Andrey-Nedov/DRUID-humanoid-robot/imgs/c1/1.jpg

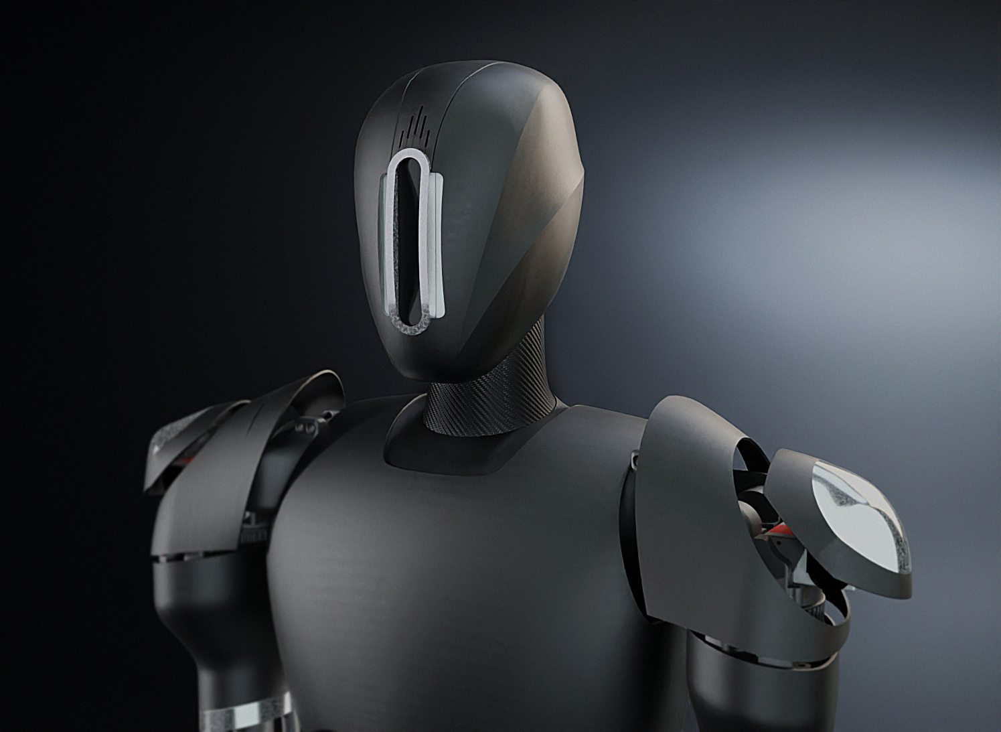
imgs/c1/1.jpg
