Andrey-Nedov/DRUID-humanoid-robot/imgs/c1/2.jpg

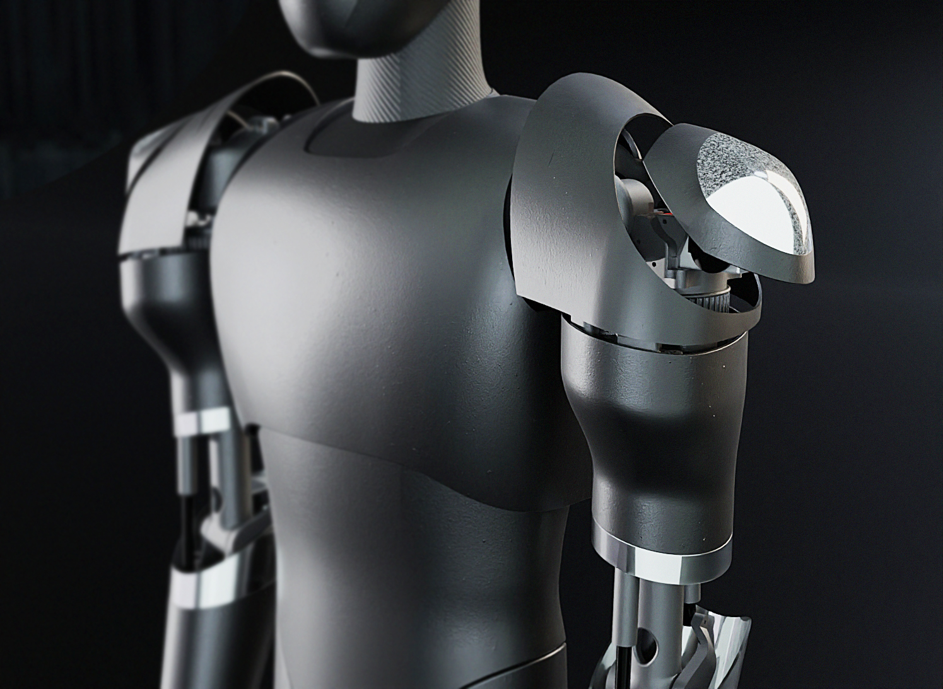
imgs/c1/2.jpg
