Andrey-Nedov/DRUID-humanoid-robot/imgs/c1/3.jpg

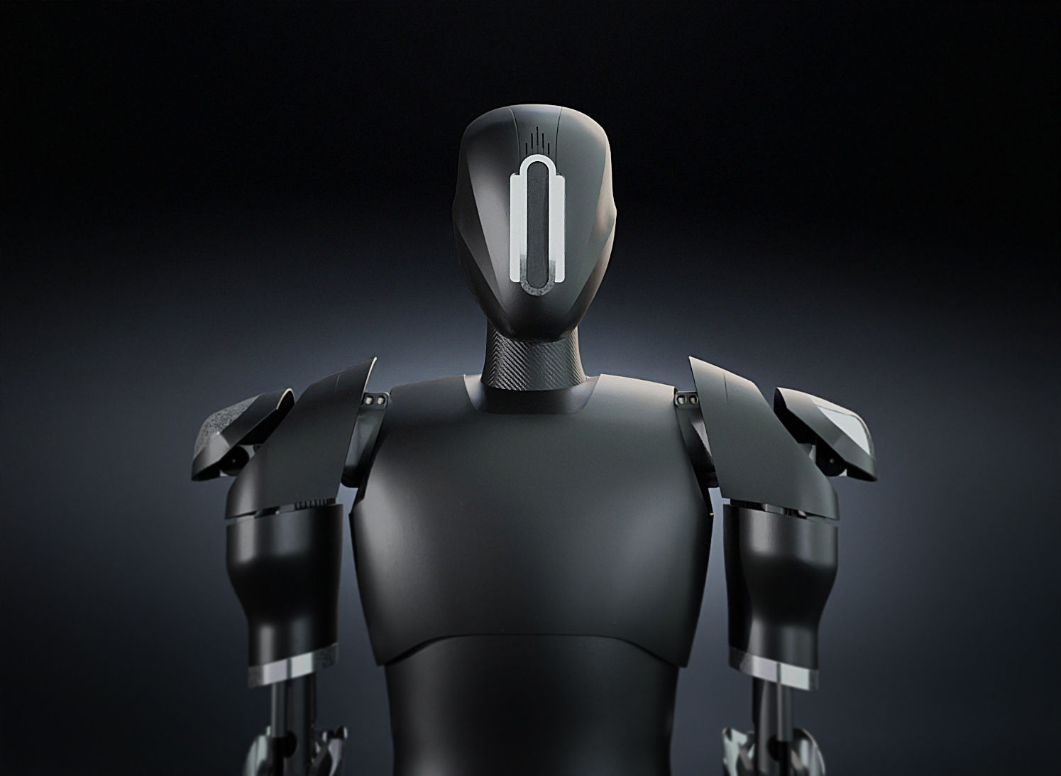
imgs/c1/3.jpg
