Andrey-Nedov/DRUID-humanoid-robot/imgs/c1/4.jpg

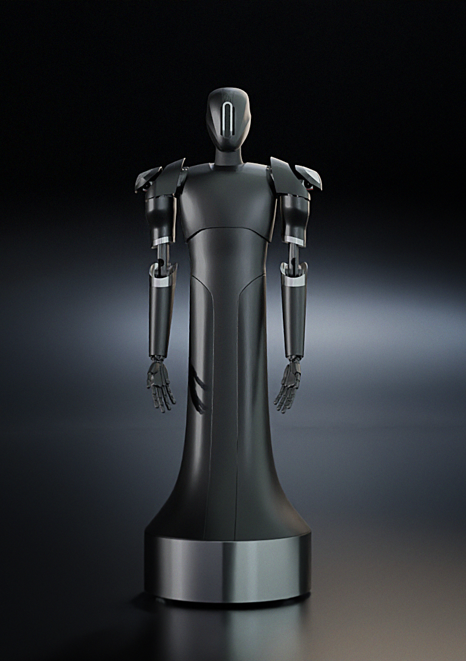
imgs/c1/4.jpg
