Andrey-Nedov/DRUID-humanoid-robot/imgs/c1/5.jpg

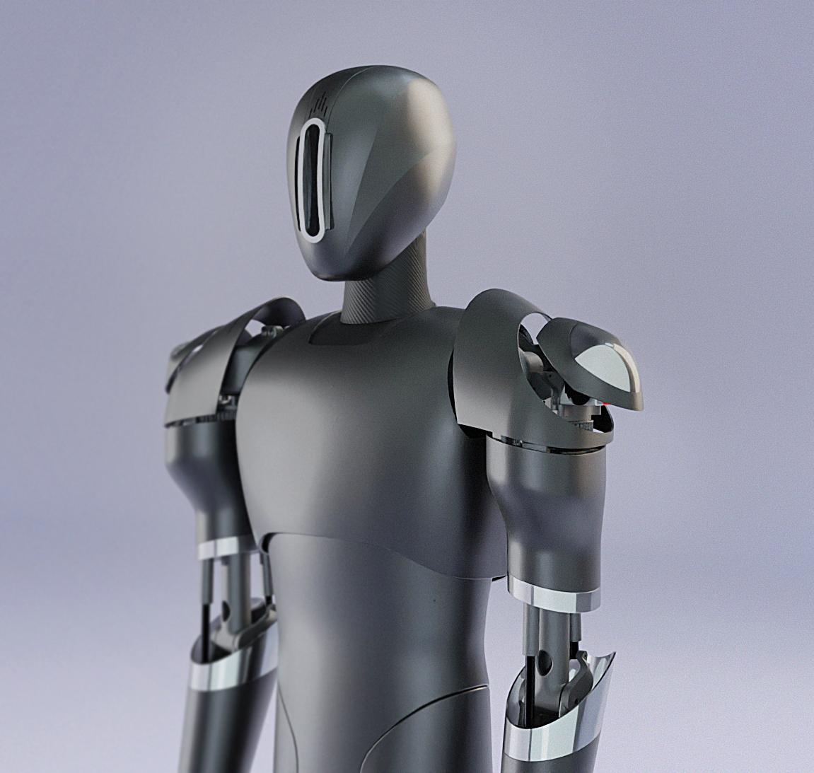
imgs/c1/5.jpg
