Andrey-Nedov/DRUID-humanoid-robot/imgs/c1/6.jpg

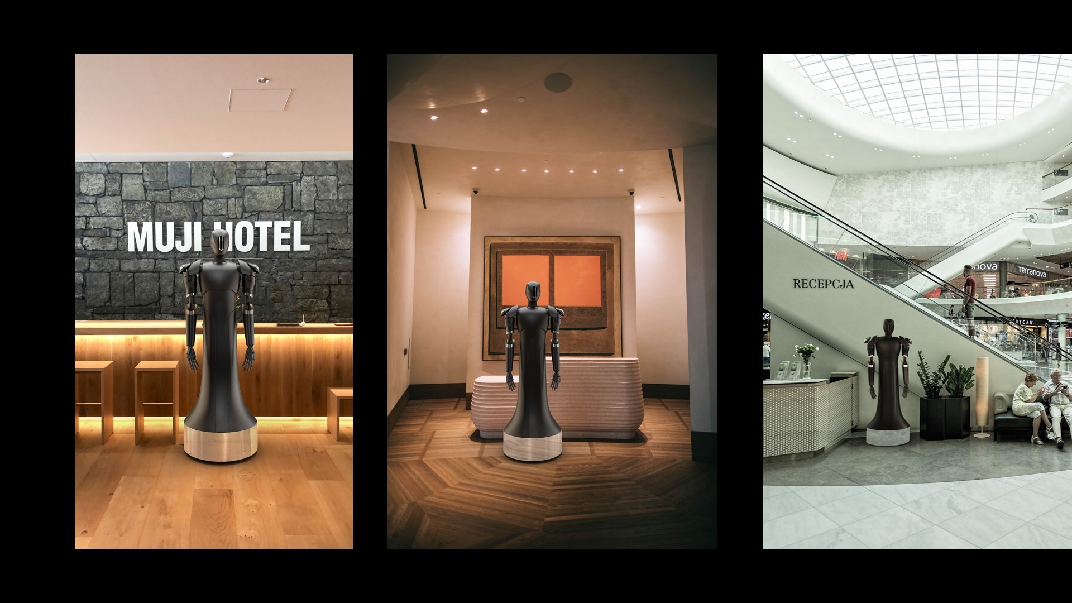
imgs/c1/6.jpg
