Andrey-Nedov/DRUID-humanoid-robot/imgs/c1/c1_1_full-hd.png

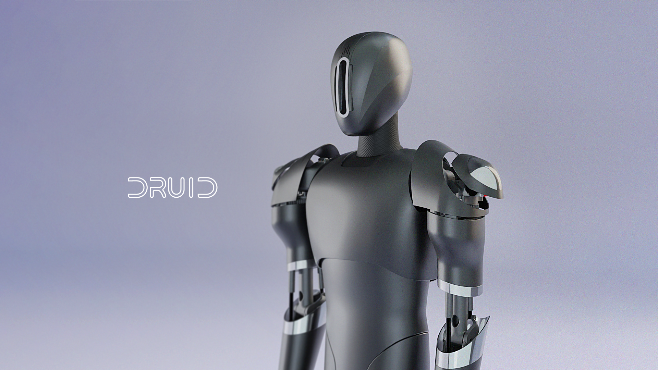
imgs/c1/c1_1_full-hd.png
