Andrey-Nedov/DRUID-humanoid-robot/imgs/c1/c1_2_git.png

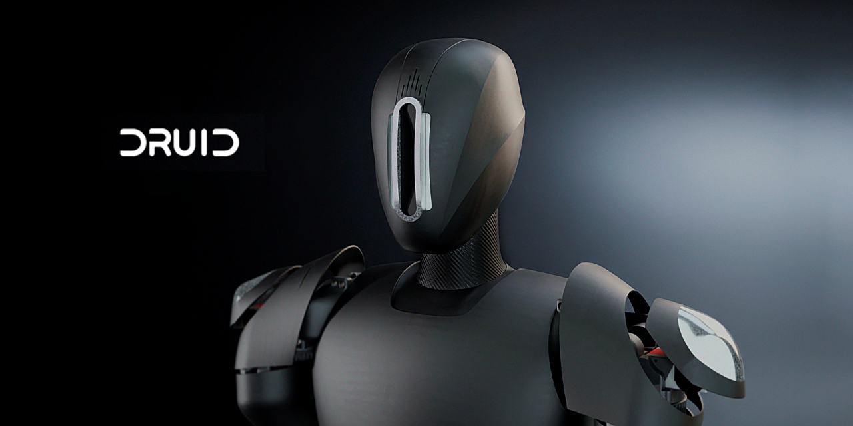
imgs/c1/c1_2_git.png
