Andrey-Nedov/DRUID-humanoid-robot/imgs/c1_2/1.jpg

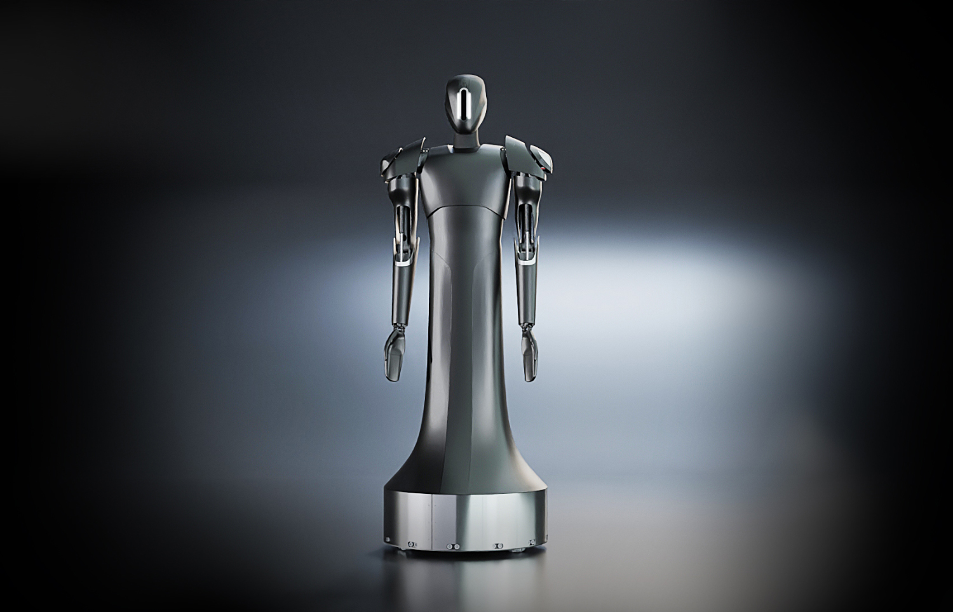
imgs/c1_2/1.jpg
