Andrey-Nedov/DRUID-humanoid-robot/imgs/c1_2/4.jpg

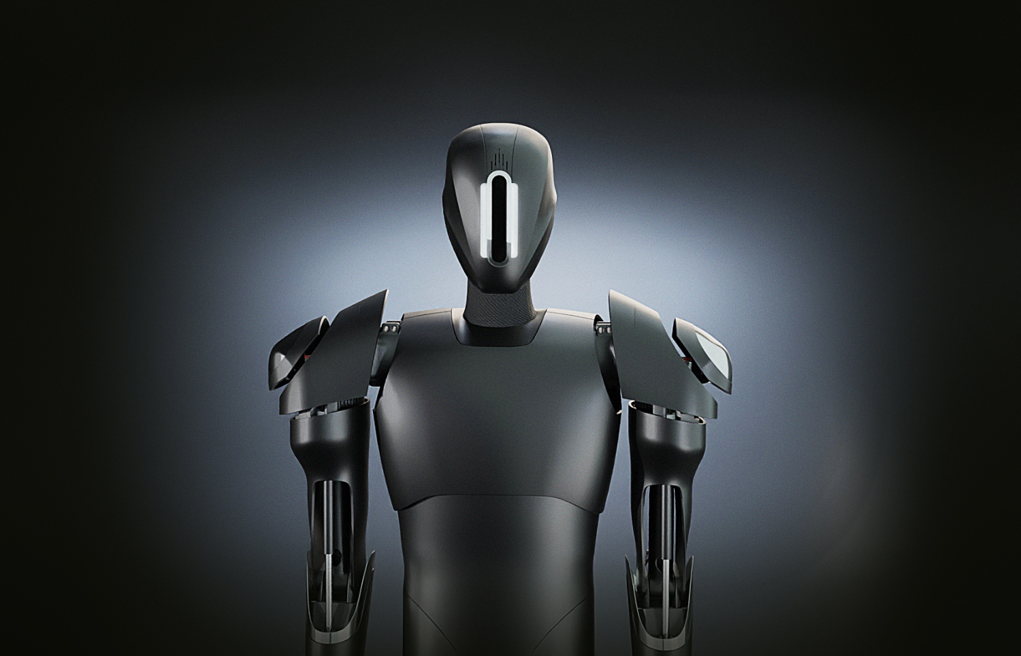
imgs/c1_2/4.jpg
