Andrey-Nedov/DRUID-humanoid-robot/imgs/c1_2/5.jpg

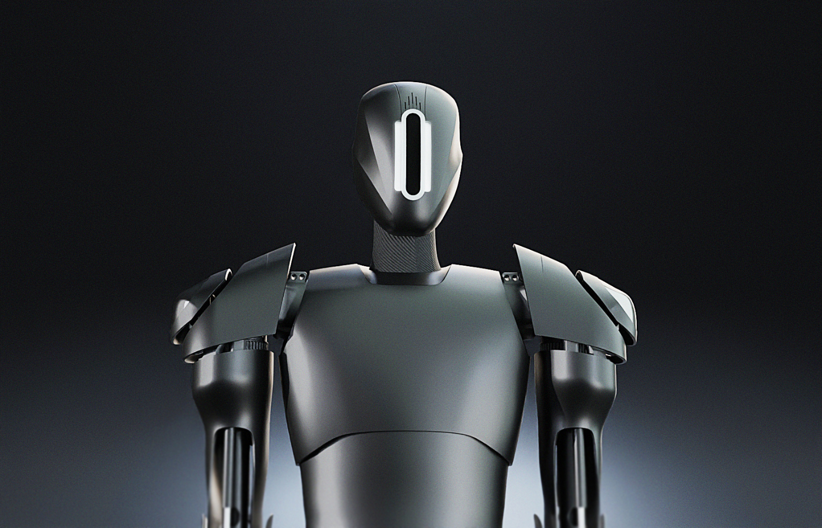
imgs/c1_2/5.jpg
