Andrey-Nedov/DRUID-humanoid-robot/imgs/c1_2/druid.png

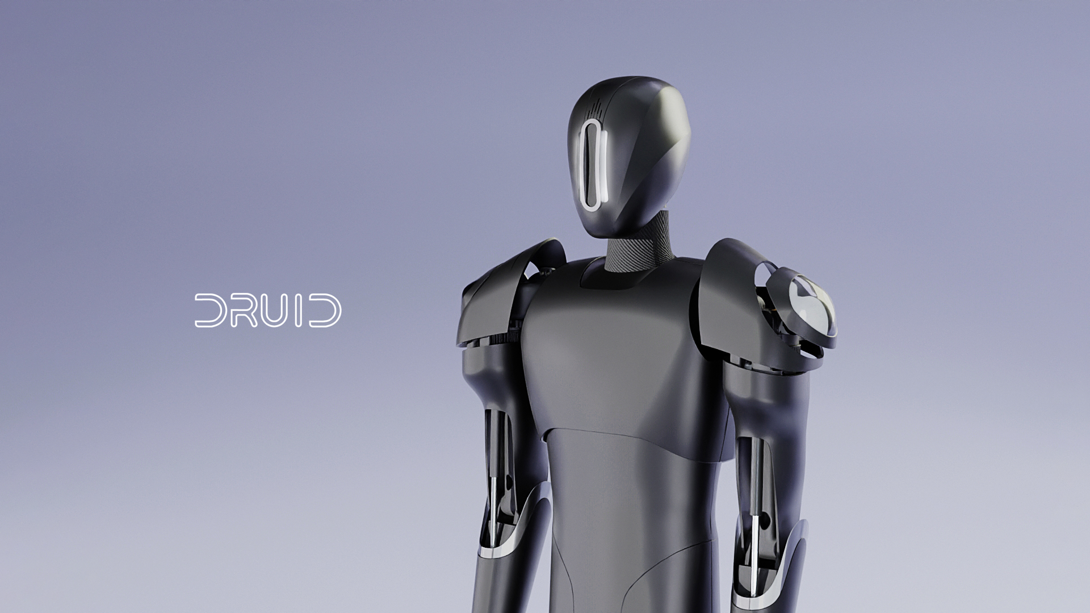
imgs/c1_2/druid.png
