Andrey-Nedov/DRUID-humanoid-robot/imgs/docs/OS.png

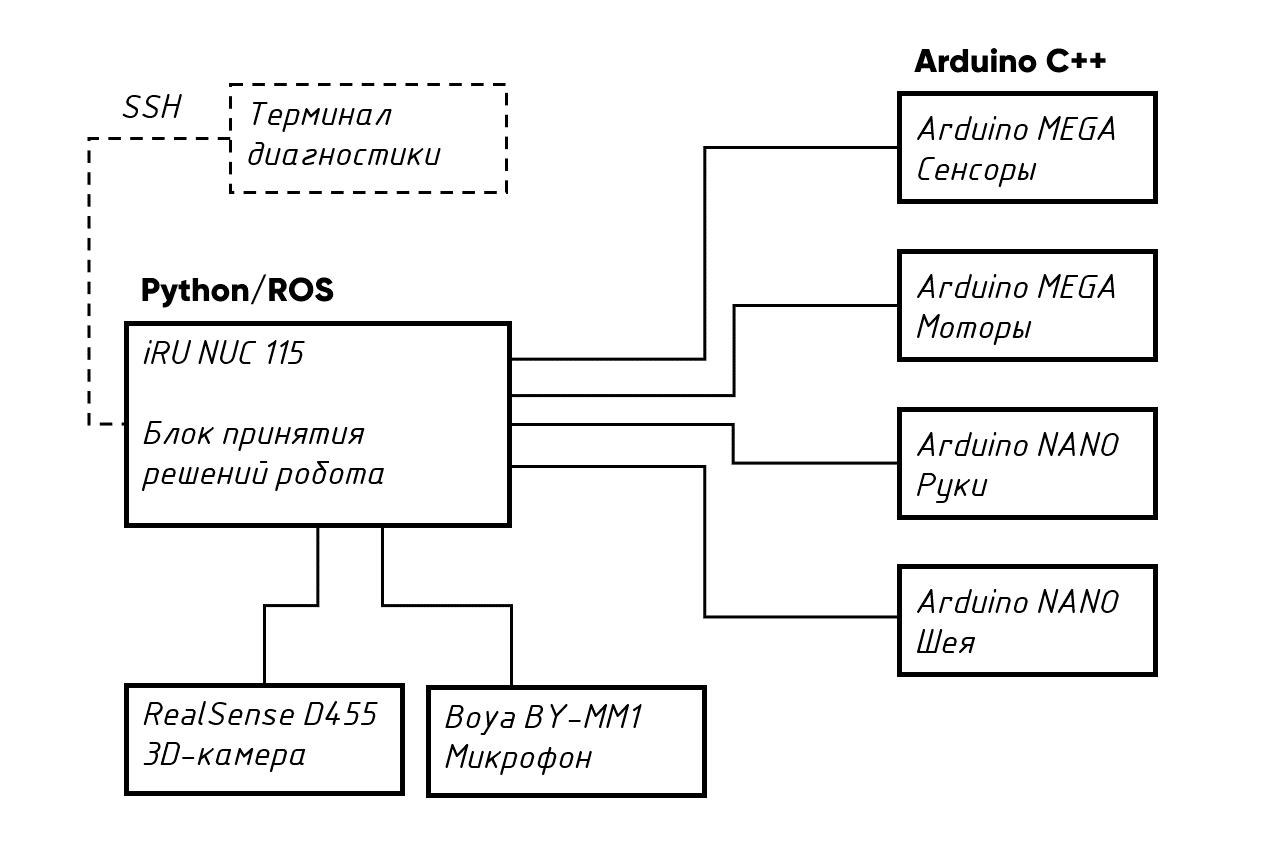
imgs/docs/OS.png
