Andrey-Nedov/DRUID-humanoid-robot/imgs/docs/pl_soft.png

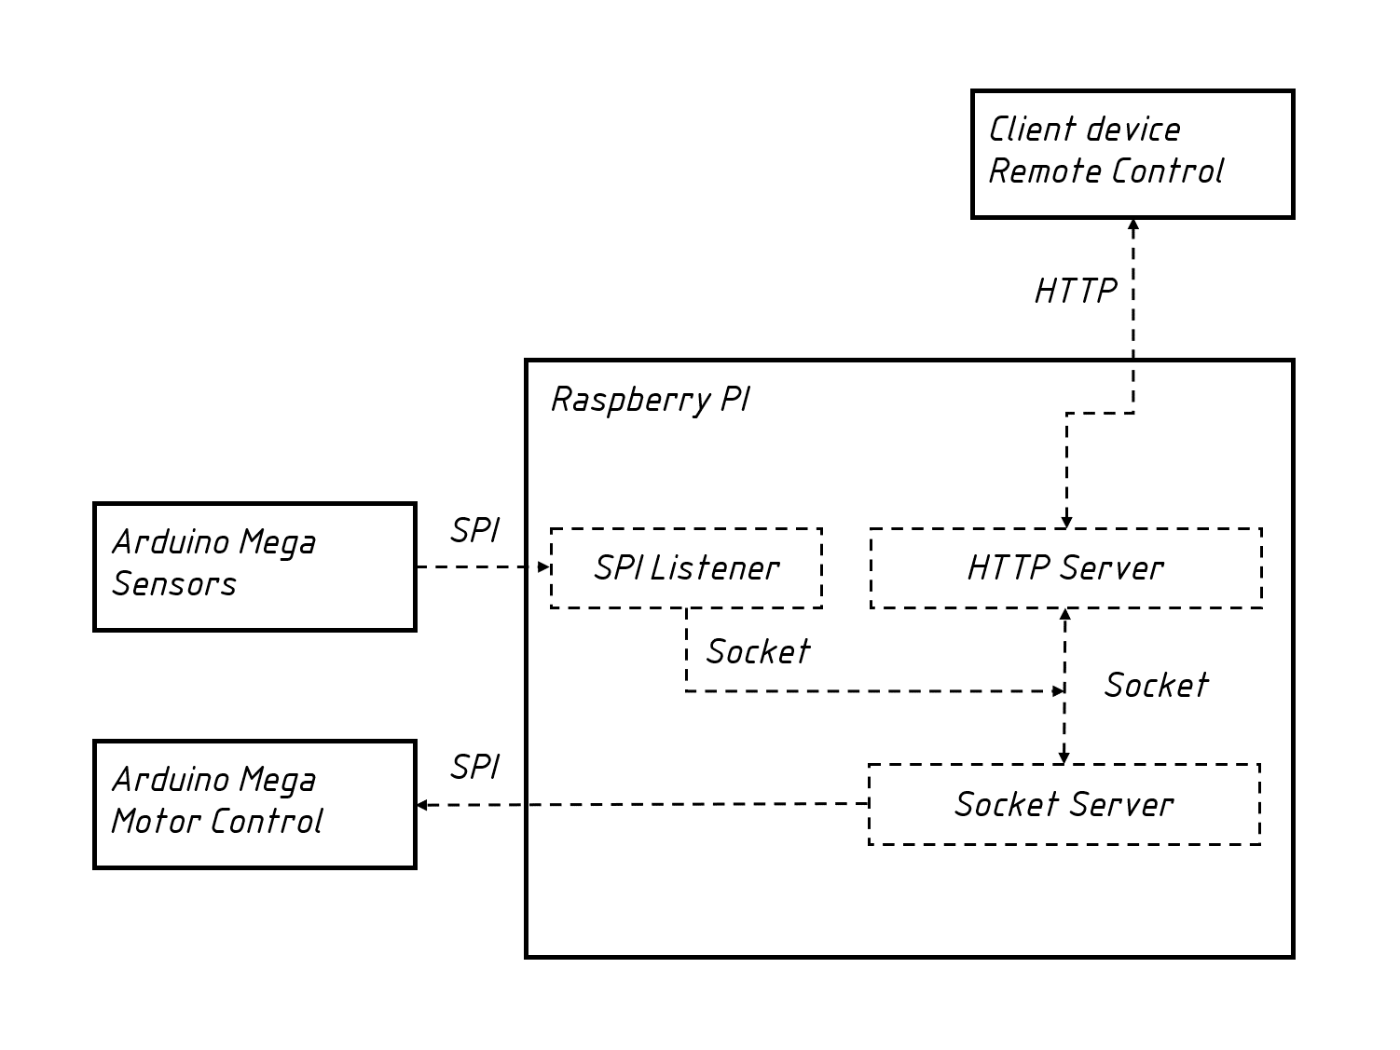
imgs/docs/pl_soft.png
