Andrey-Nedov/DRUID-humanoid-robot/imgs/photos/2.jpg

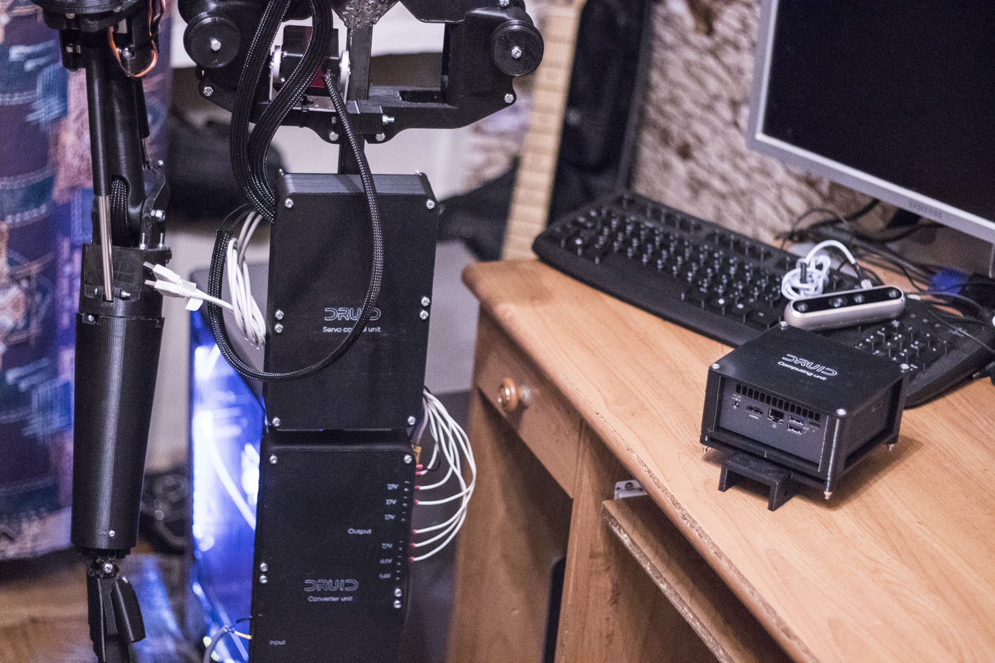
imgs/photos/2.jpg
