Andrey-Nedov/DRUID-humanoid-robot/imgs/photos/2_1.jpg

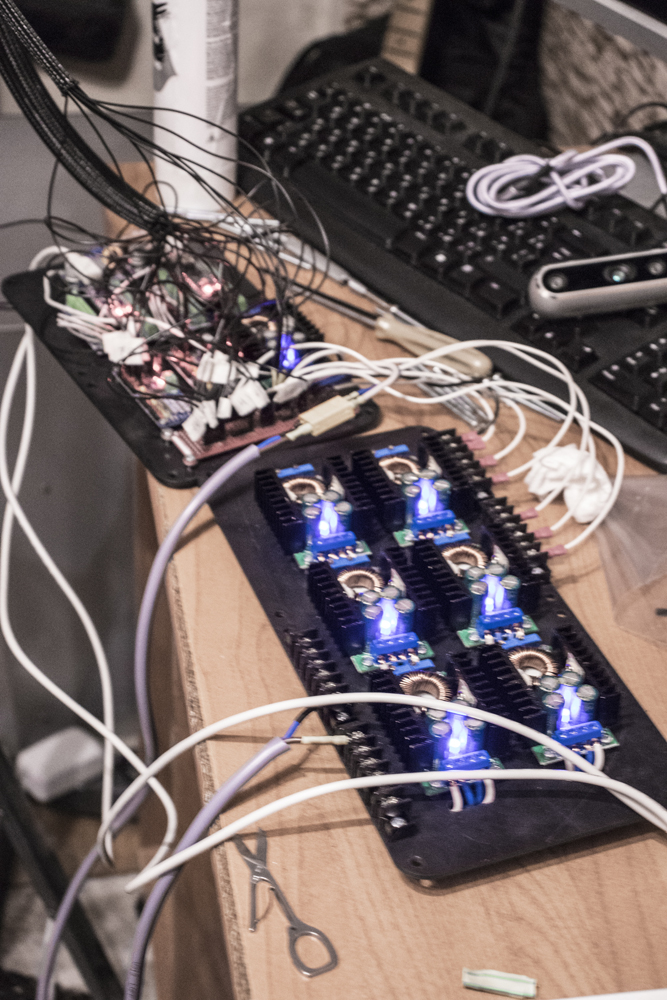
imgs/photos/2_1.jpg
