Andrey-Nedov/DRUID-humanoid-robot/imgs/photos/2_2.jpg

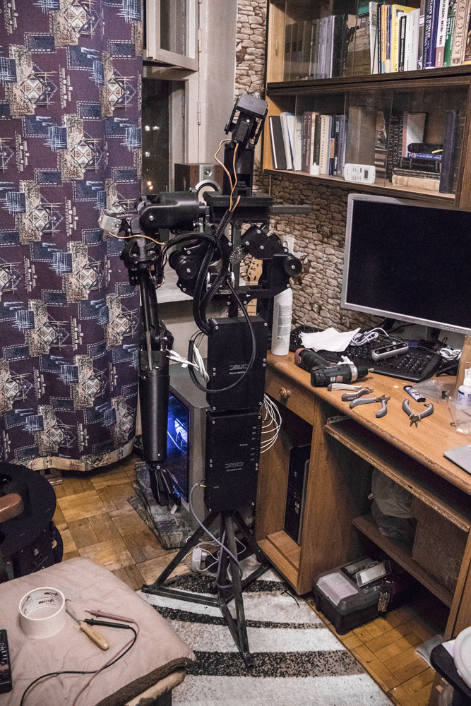
imgs/photos/2_2.jpg
