Andrey-Nedov/DRUID-humanoid-robot/imgs/photos/2_3.jpg

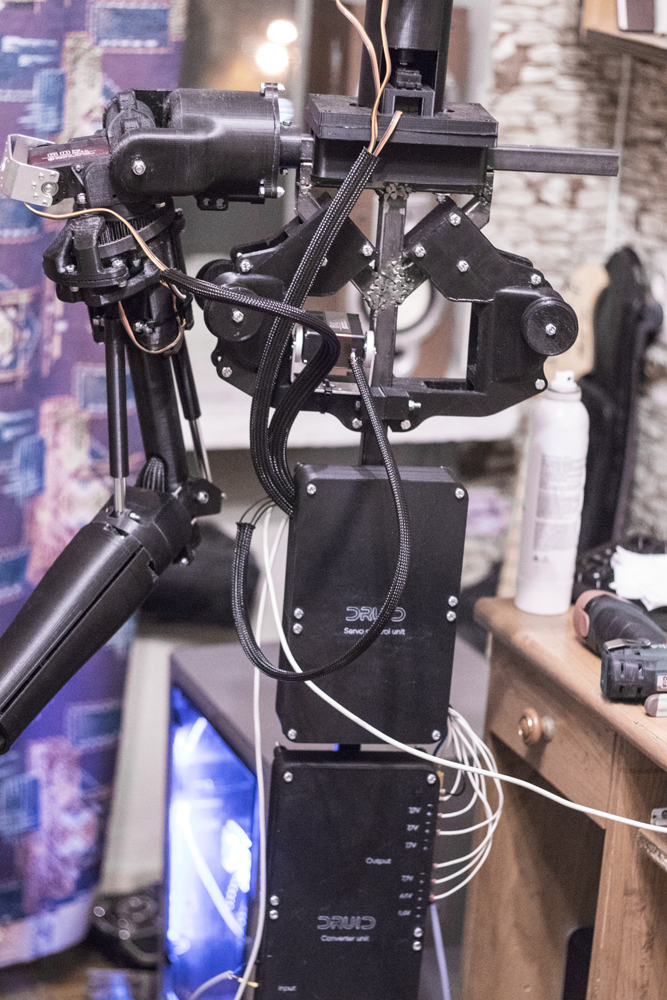
imgs/photos/2_3.jpg
