Andrey-Nedov/DRUID-humanoid-robot/imgs/photos/2_6.jpg

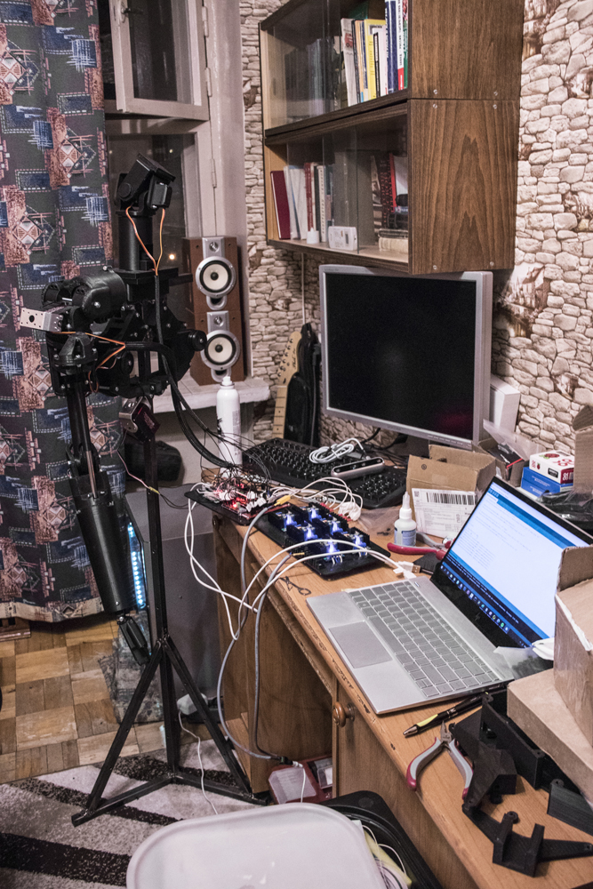
imgs/photos/2_6.jpg
