Andrey-Nedov/DRUID-humanoid-robot/imgs/photos/2_16.jpg

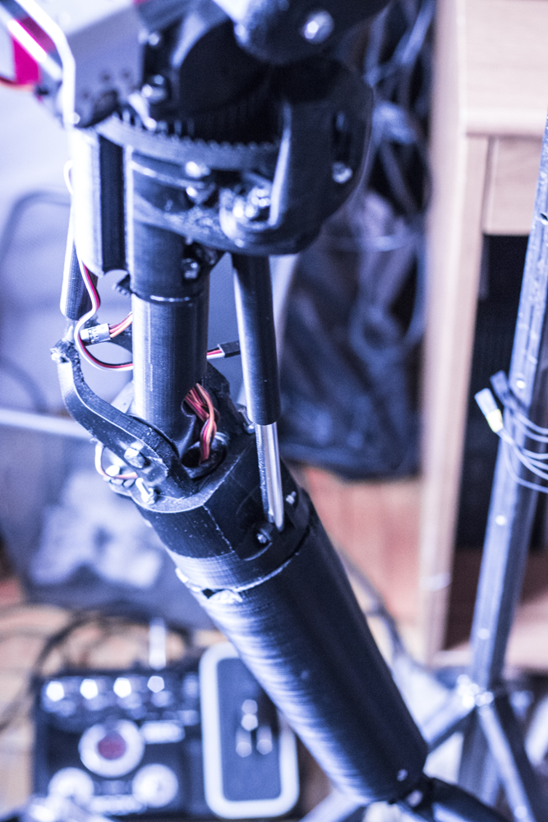
imgs/photos/2_16.jpg
