Andrey-Nedov/DRUID-humanoid-robot/imgs/photos/2_18.jpg

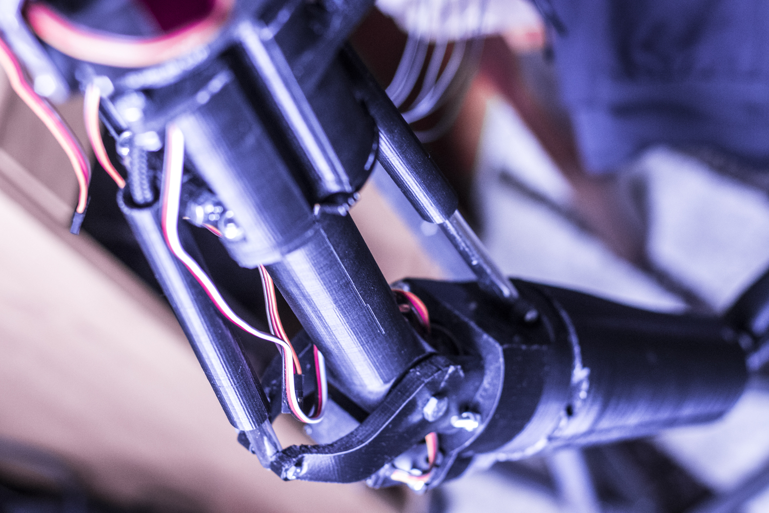
imgs/photos/2_18.jpg
