Andrey-Nedov/DRUID-humanoid-robot/imgs/photos/2_20.jpg

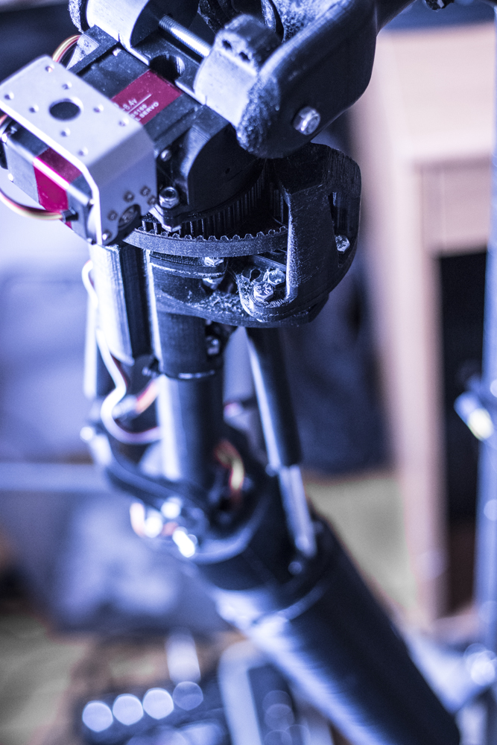
imgs/photos/2_20.jpg
