Andrey-Nedov/DRUID-humanoid-robot/imgs/photos/3.png

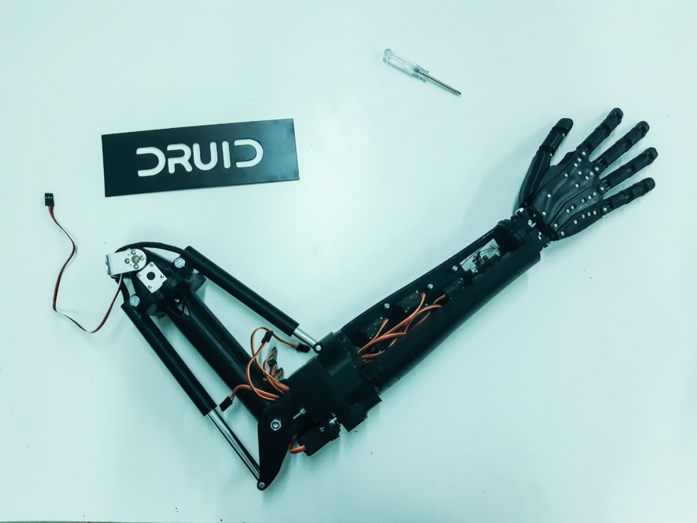
imgs/photos/3.png
