Andrey-Nedov/DRUID-humanoid-robot/imgs/photos/5.jpg

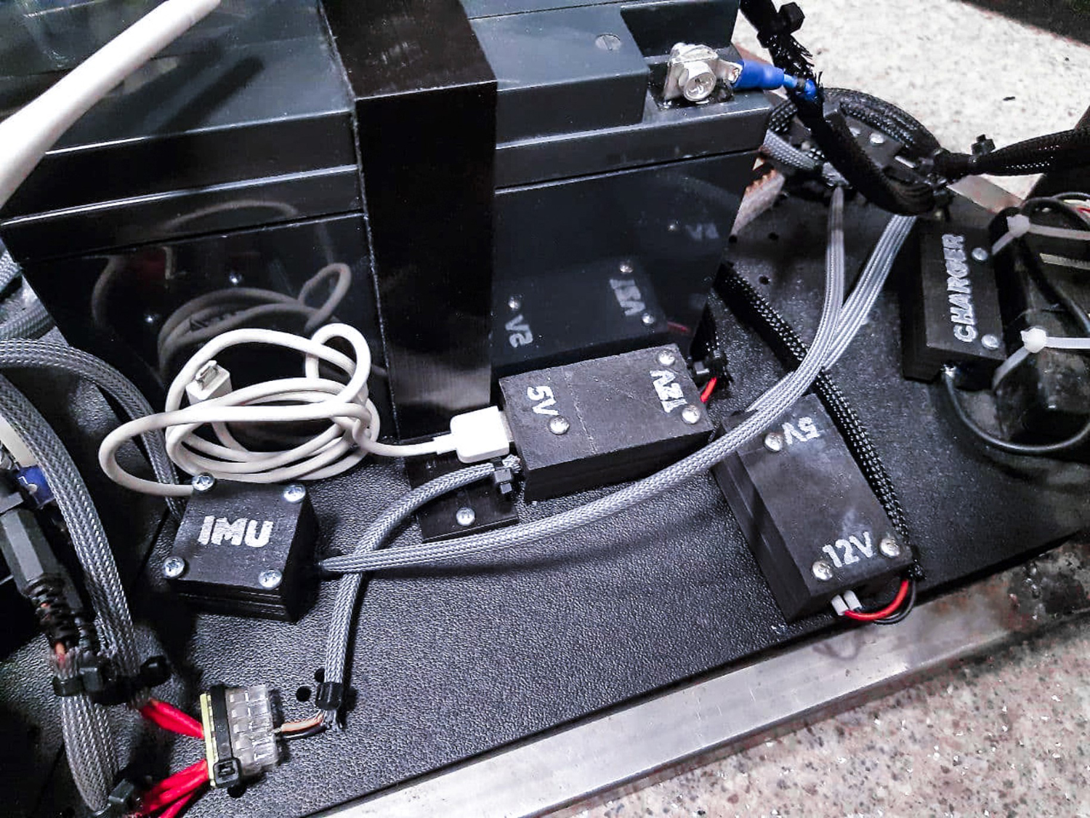
imgs/photos/5.jpg
