Andrey-Nedov/DRUID-humanoid-robot/imgs/photos/6.jpg

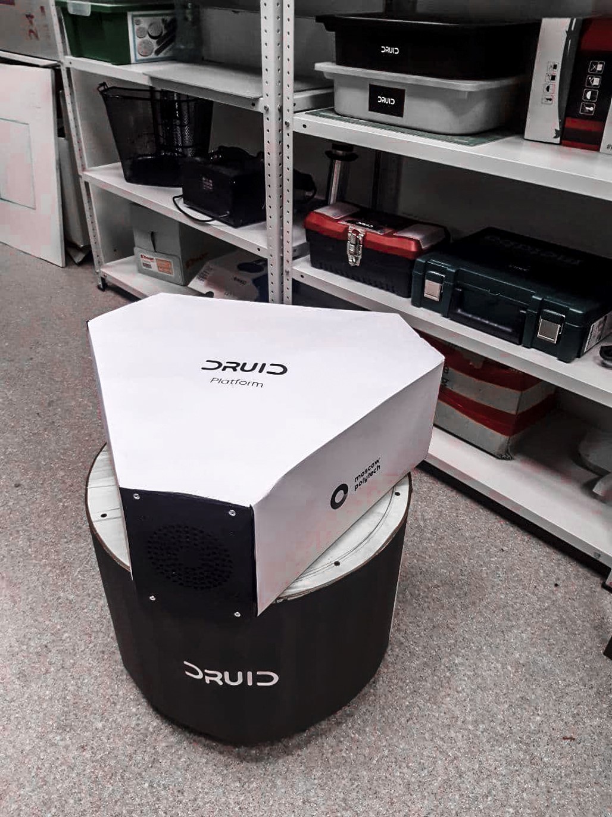
imgs/photos/6.jpg
