Andrey-Nedov/DRUID-humanoid-robot/imgs/photos/10.jpg

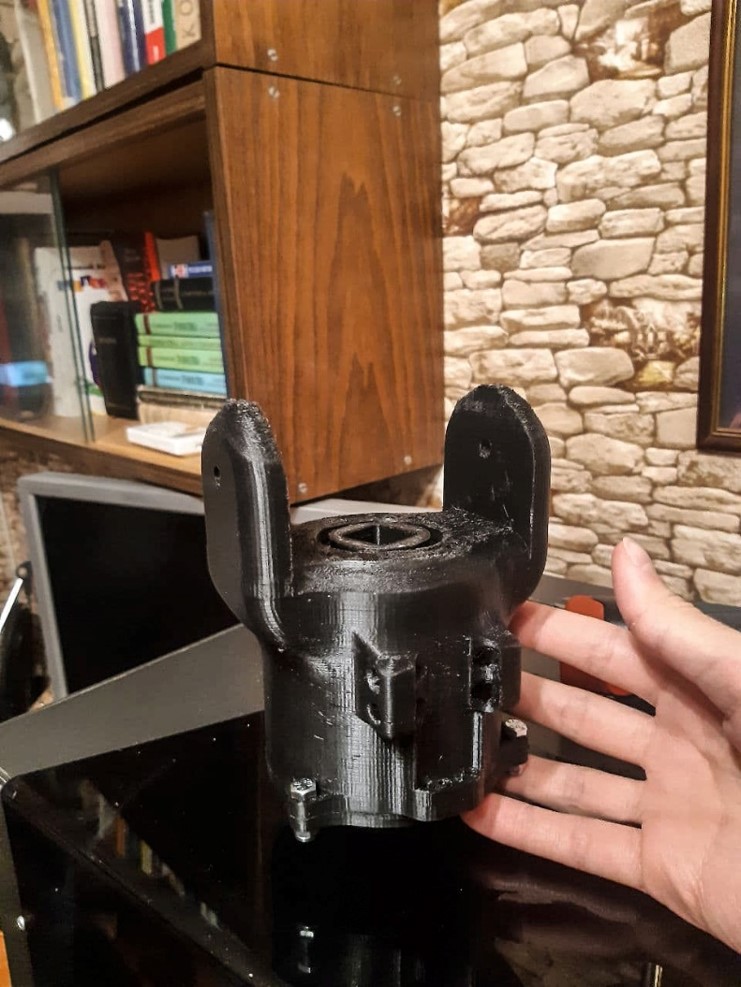
imgs/photos/10.jpg
