Andrey-Nedov/DRUID-humanoid-robot/imgs/photos/face.png

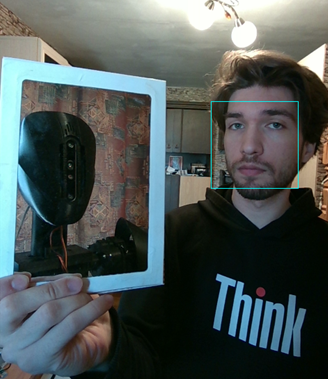
imgs/photos/face.png
