Andrey-Nedov/DRUID-humanoid-robot/imgs/photos/face_2.png

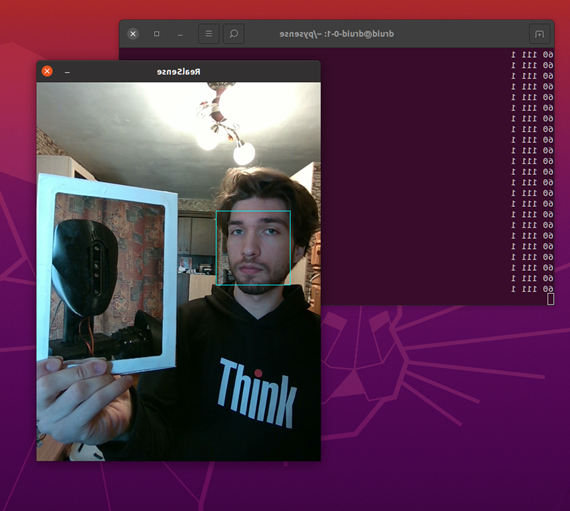
imgs/photos/face_2.png
