Andrey-Nedov/DRUID-humanoid-robot/imgs/photos/next.jpg

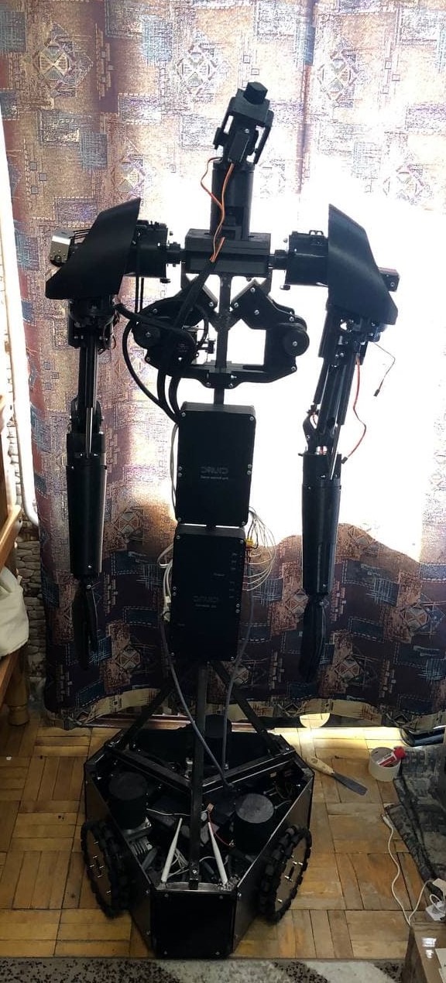
imgs/photos/next.jpg
