Andrey-Nedov/DRUID-humanoid-robot/imgs/renders/1.jpg

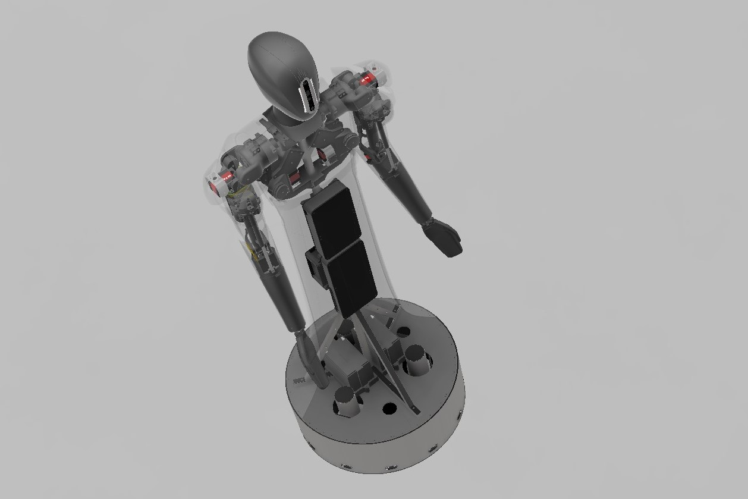
imgs/renders/1.jpg
