Andrey-Nedov/DRUID-humanoid-robot/imgs/renders/2.jpg

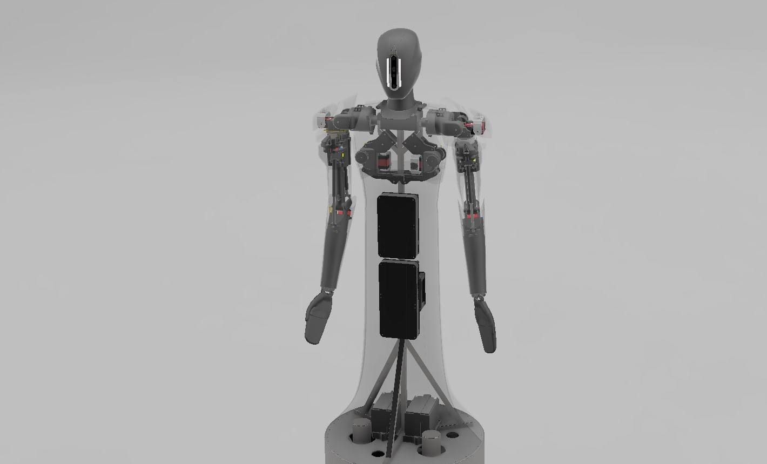
imgs/renders/2.jpg
