Andrey-Nedov/DRUID-humanoid-robot/imgs/renders/bot.gif

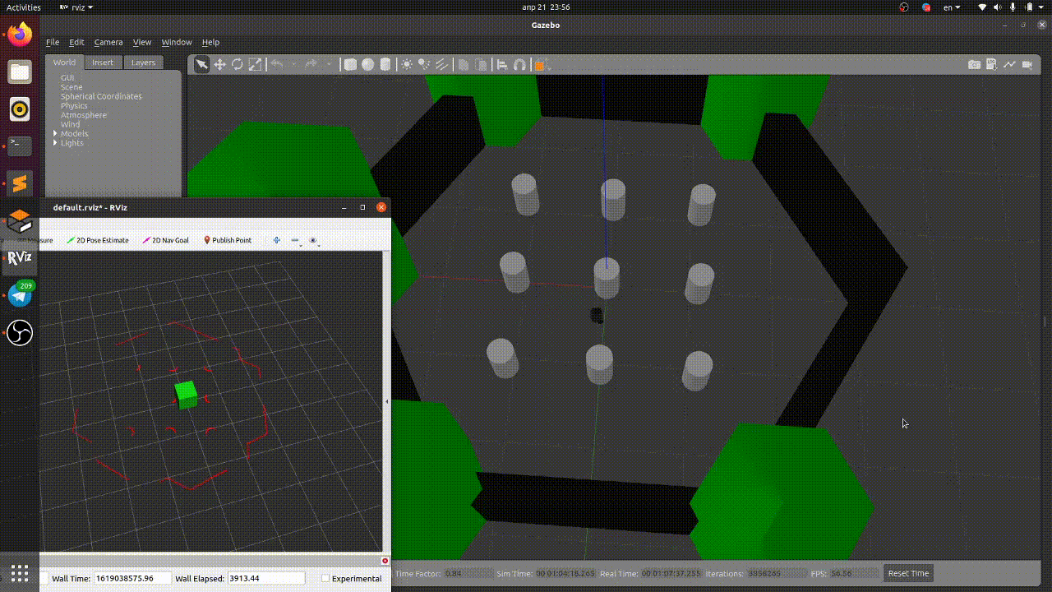
imgs/renders/bot.gif
