Andrey-Nedov/DRUID-humanoid-robot/imgs/renders/bot.png

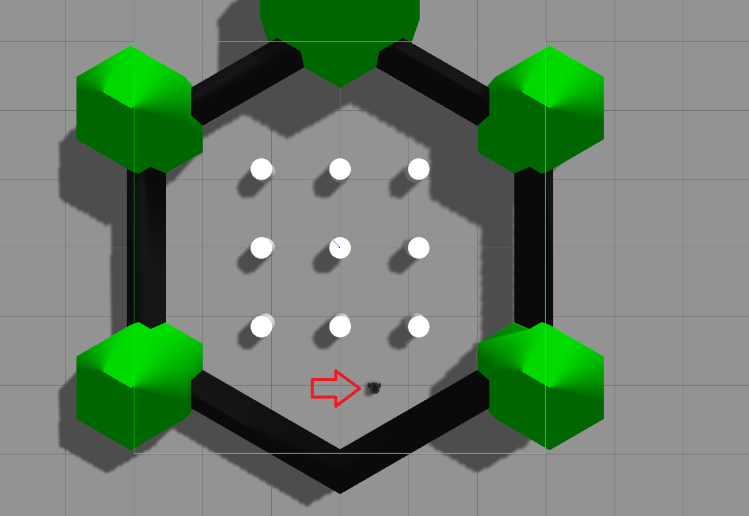
imgs/renders/bot.png
