Andrey-Nedov/DRUID-humanoid-robot/imgs/renders/constr.jpg

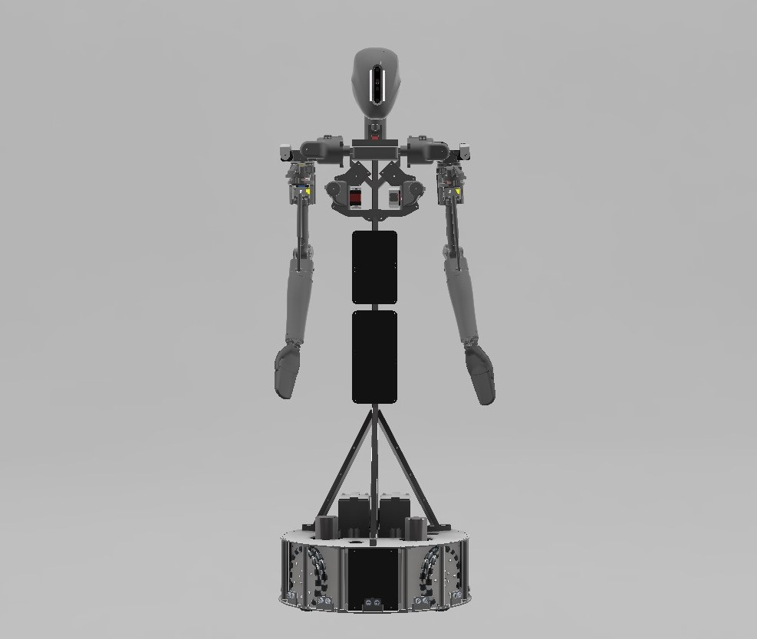
imgs/renders/constr.jpg
