Andrey-Nedov/DRUID-humanoid-robot/imgs/renders/hand.jpg

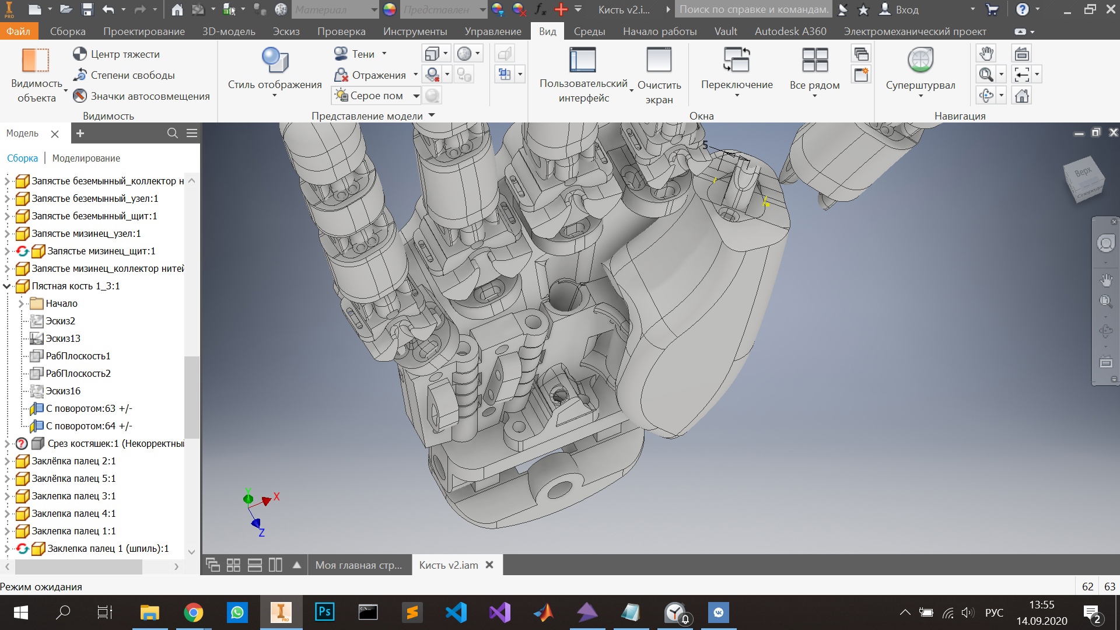
imgs/renders/hand.jpg
