Andrey-Nedov/DRUID-humanoid-robot/imgs/renders/platform/2.png

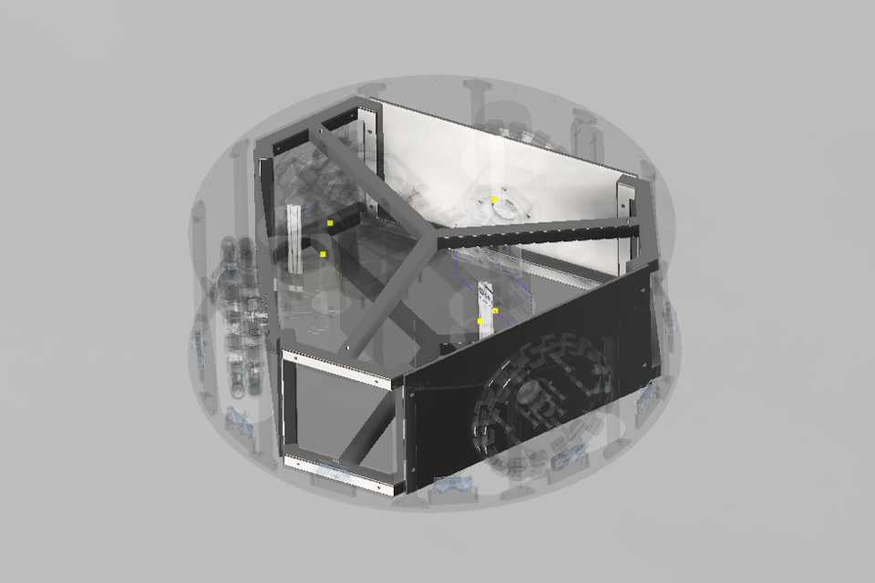
imgs/renders/platform/2.png
