Andrey-Nedov/DRUID-humanoid-robot/imgs/renders/platform/3.png

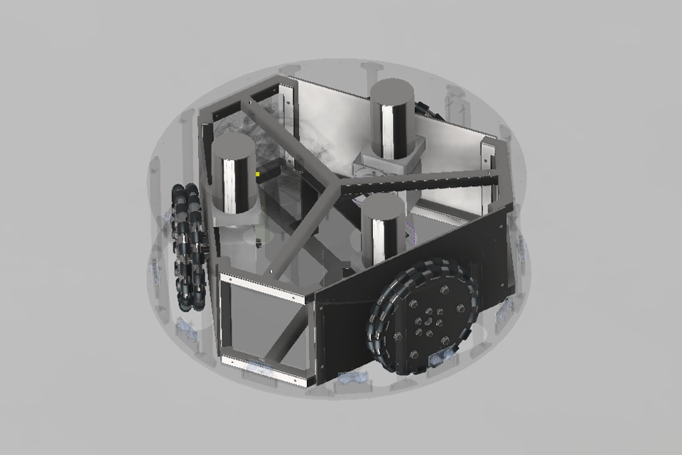
imgs/renders/platform/3.png
