Andrey-Nedov/DRUID-humanoid-robot/imgs/renders/platform/4.png

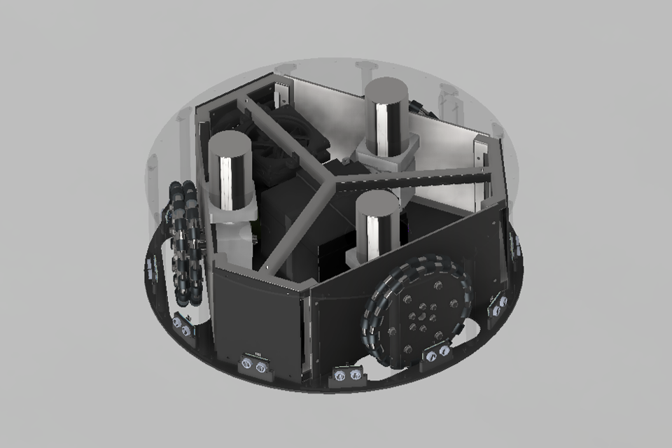
imgs/renders/platform/4.png
