Andrey-Nedov/DRUID-humanoid-robot/imgs/renders/platform/5.png

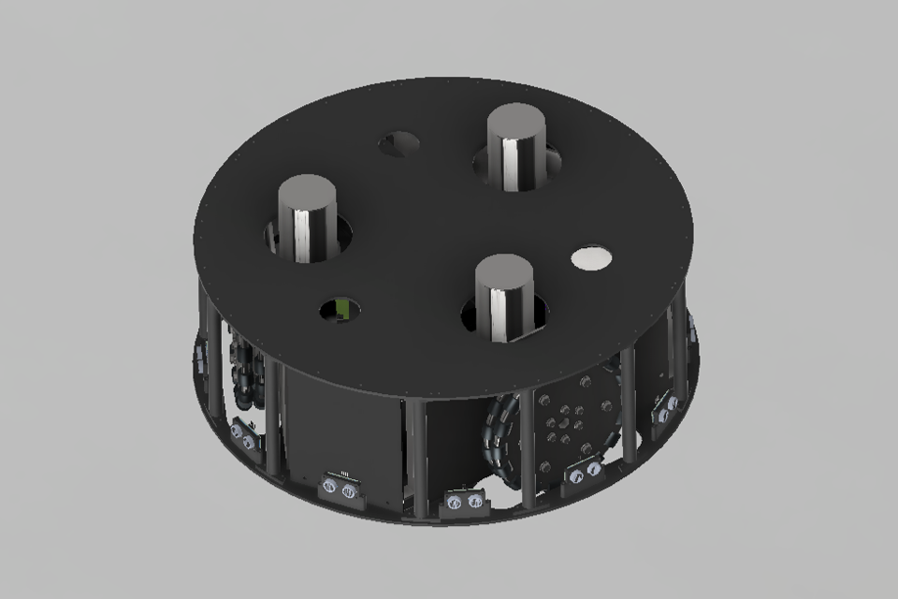
imgs/renders/platform/5.png
