Andrey-Nedov/DRUID-humanoid-robot/imgs/renders/platform/6.png

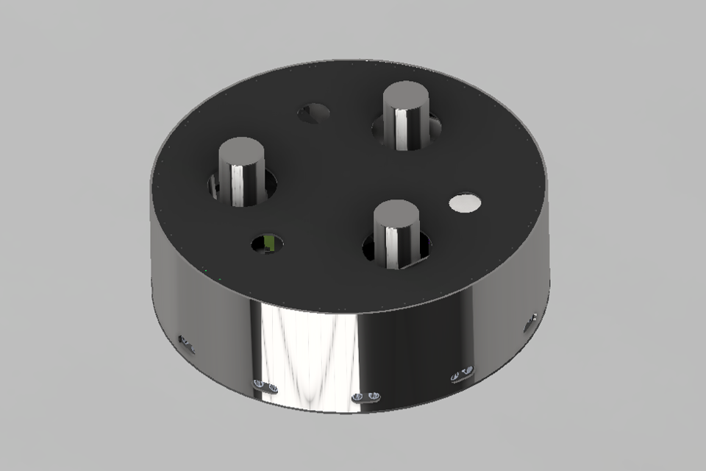
imgs/renders/platform/6.png
