Andrey-Nedov/DRUID-humanoid-robot/imgs/renders/platform/7.jpg

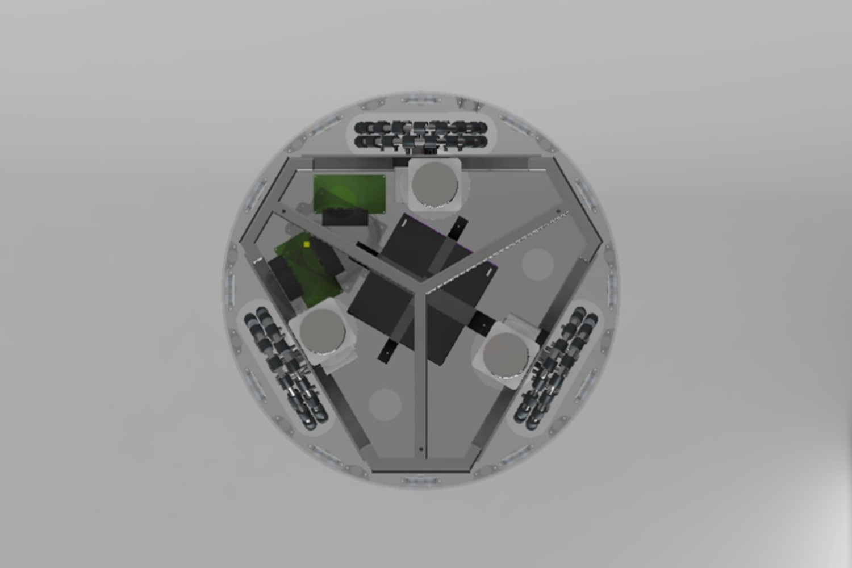
imgs/renders/platform/7.jpg
