Andrey-Nedov/DRUID-humanoid-robot/imgs/renders/platform/10.png

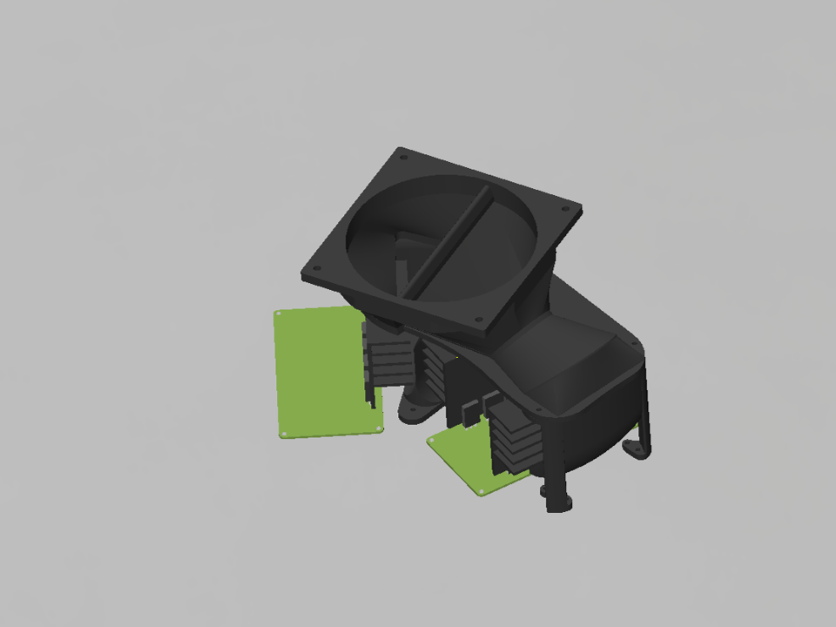
imgs/renders/platform/10.png
