Andrey-Nedov/DRUID-humanoid-robot/imgs/renders/platform/11.png

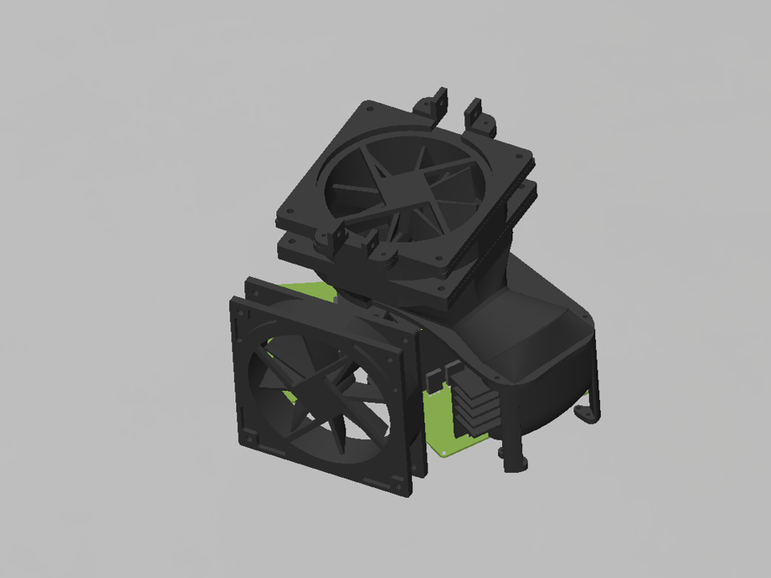
imgs/renders/platform/11.png
