Andrey-Nedov/DRUID-humanoid-robot/imgs/renders/platform/12.png

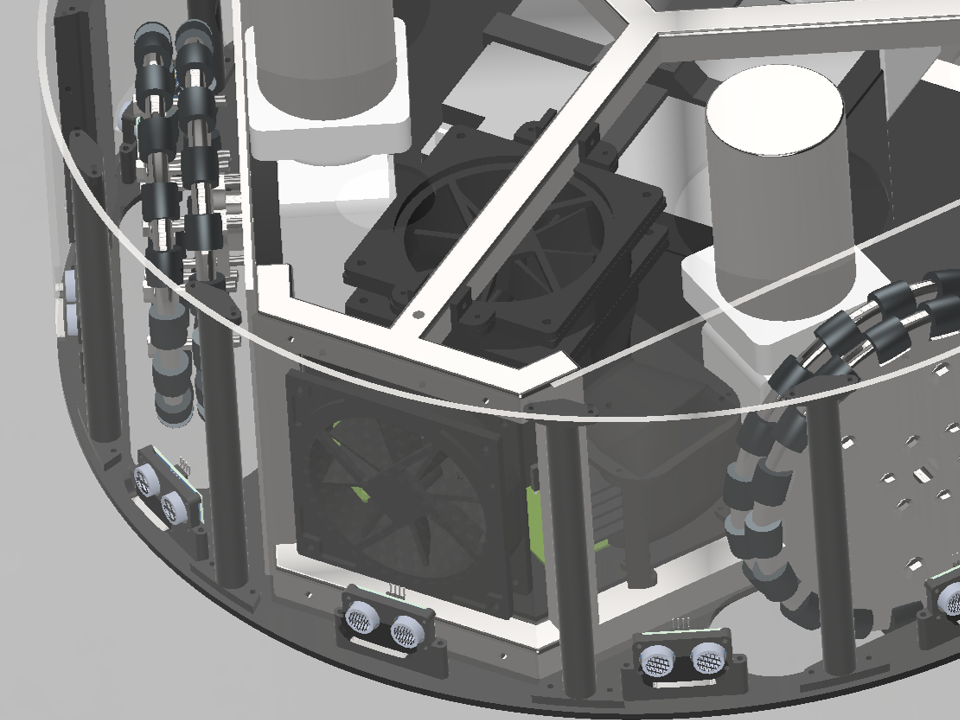
imgs/renders/platform/12.png
