Andrey-Nedov/DRUID-humanoid-robot/imgs/renders/platform/13.png

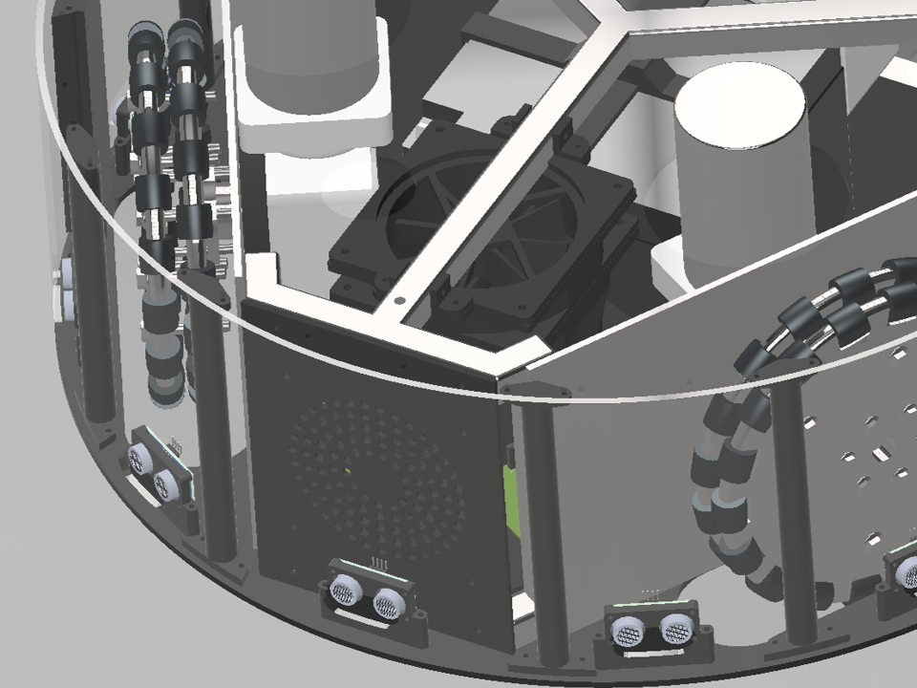
imgs/renders/platform/13.png
