Andrey-Nedov/DRUID-humanoid-robot/imgs/sketches/sc1.png

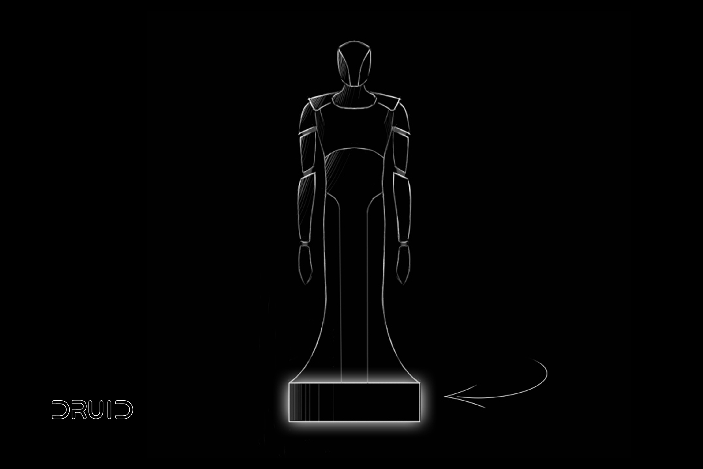
imgs/sketches/sc1.png
