Andrey-Nedov/DRUID-humanoid-robot/imgs/sketches/SharedScreenshot.jpg

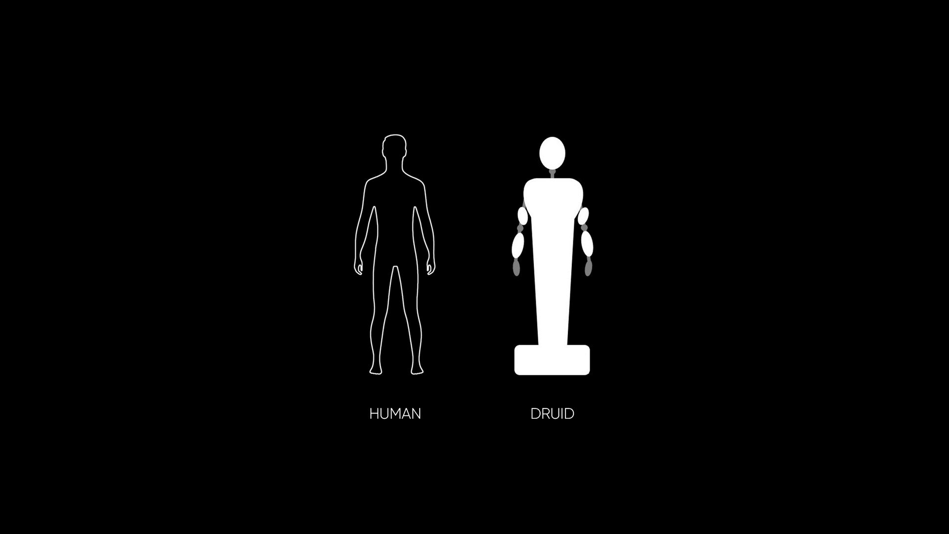
imgs/sketches/SharedScreenshot.jpg
