Andrey-Nedov/DRUID-humanoid-robot/imgs/software/face.gif

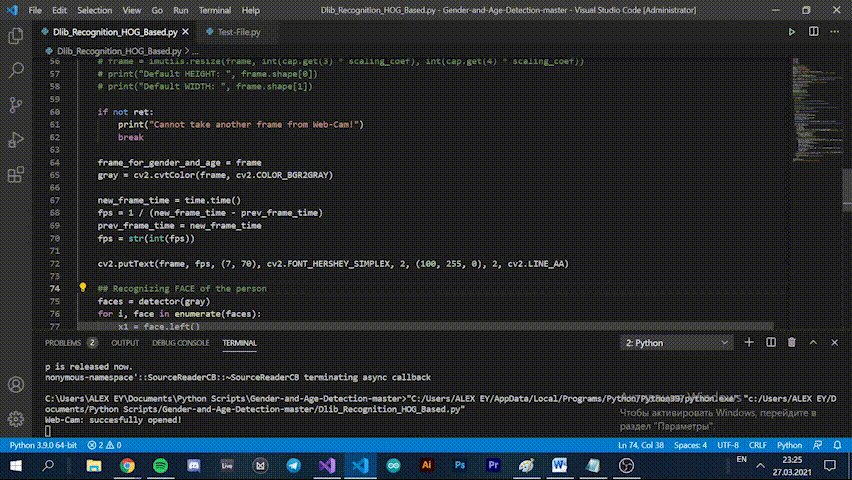
imgs/software/face.gif
