Andrey-Nedov/DRUID-humanoid-robot/imgs/software/OSsch2.png

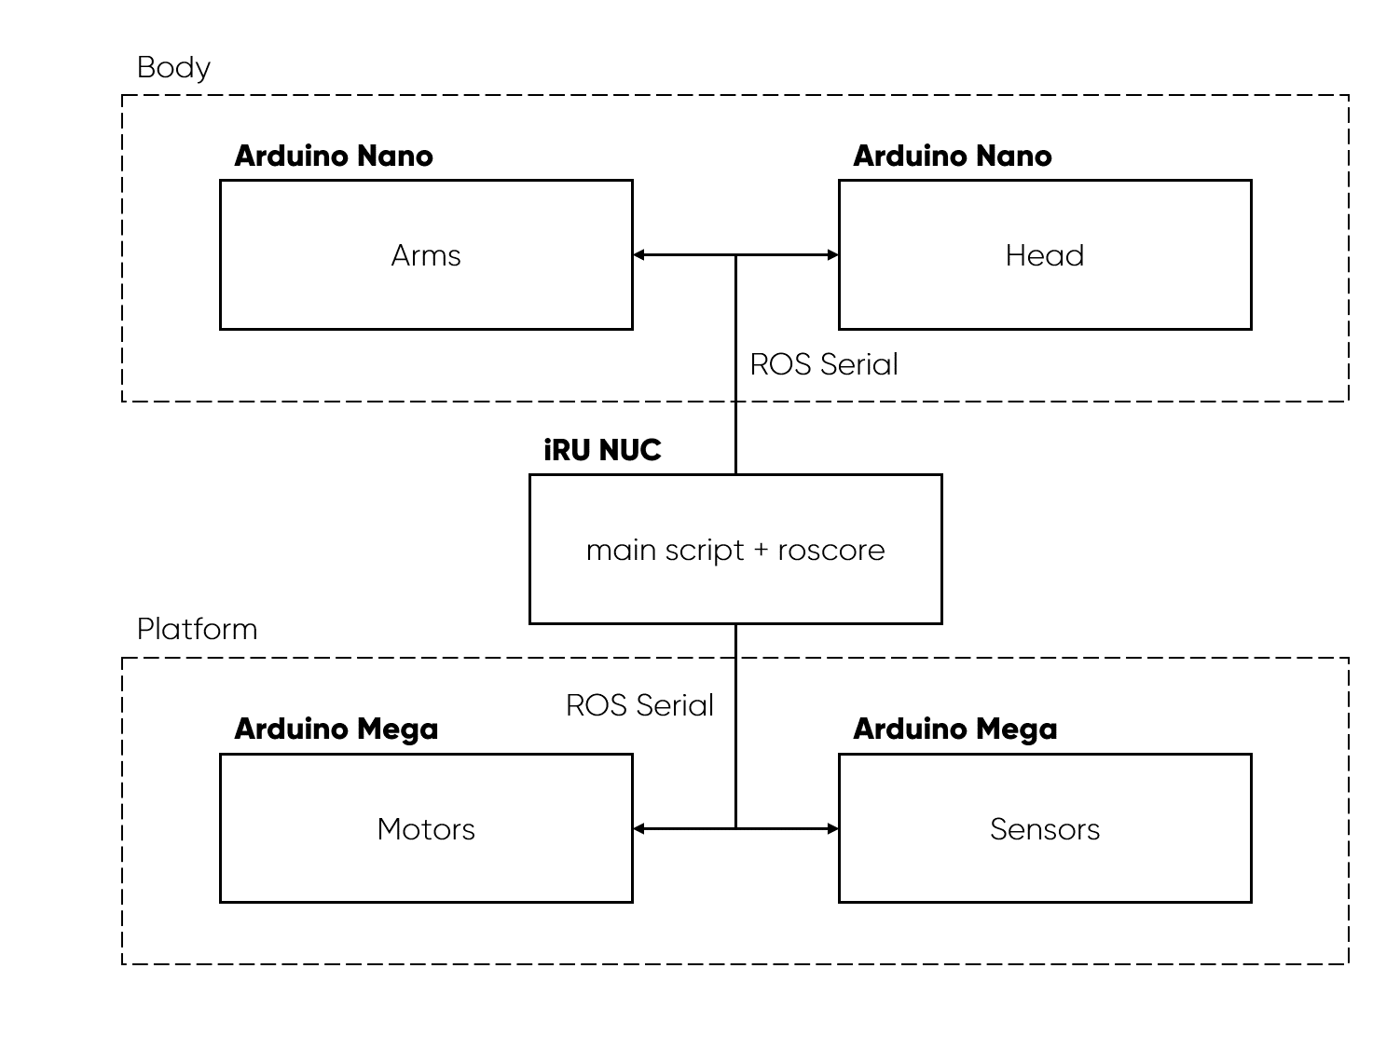
imgs/software/OSsch2.png
