Andrey-Nedov/DRUID-humanoid-robot/imgs/docs/result_vect.png

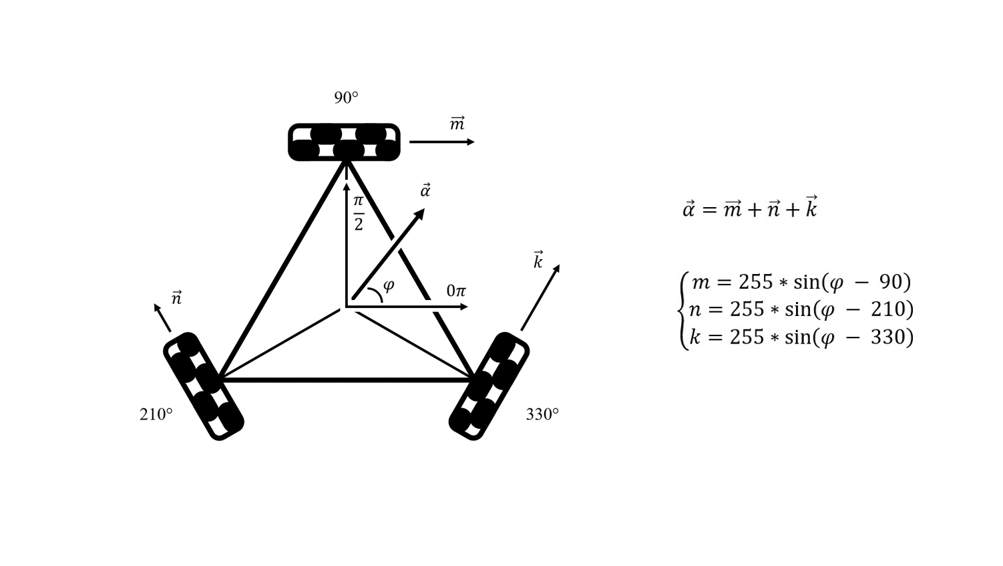
imgs/docs/result_vect.png
